sobikk/mouse/Mouse_design/Mouse_HW/vyroba/verze_1/BOM.ods

Označení | Velikost, typ | Pouzdro | Kód TME | Cena | Odkaz | Poznámky
C1 | 220k | 0402_1005 | 0402X224K100CT | 0,29776 | https://www.tme.eu/cz/details/0402x224k6r3ct/kondenzatory-mlcc-smd-0402/walsin/ | tolerance 10% | Min 250 | 0402X224K100CT | 5
C2 | 10m | 0603_1608 | CL10A106KQ8NNNC | 2,104 | https://www.tme.eu/cz/details/cl10a106kq8nnnc/kondenzatory-mlcc-smd-0603/samsung/ | tolerance 10% |  | CL10A106KQ8NNNC | 8
C3 | 100k | 0402_1005 | 0402X104K100CT | 0,1171 | https://www.tme.eu/cz/katalog/kondenzatory-mlcc-smd-0402_100568/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 | tolerance 10% | Min. 1000 | SMD0402-20K-1% | 16
C4 | 100k | 0402_1005 | 0402X104K100CT | 0,1171 | https://www.tme.eu/cz/katalog/kondenzatory-mlcc-smd-0402_100568/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 | tolerance 10% |  | SMD0603-130R-1% | 5
C5 | 100k | 0402_1005 | 0402X104K100CT | 0,1171 | https://www.tme.eu/cz/katalog/kondenzatory-mlcc-smd-0402_100568/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 | tolerance 10% |  | SMD0402-2K | 1
C6 | 10m | 0603_1608 | CL10A106KQ8NNNC | 2,104 | https://www.tme.eu/cz/details/cl10a106kq8nnnc/kondenzatory-mlcc-smd-0603/samsung/ | tolerance 10% |  | C0402C220J5GAC | 2
C7 | 220k | 0402_1005 | 0402X224K100CT | 0,29776 | https://www.tme.eu/cz/details/0402x224k6r3ct/kondenzatory-mlcc-smd-0402/walsin/ | tolerance 10% |  | ERJ3EKF2000V | 1
C8 | 10m | 0603_1608 | CL10A106KQ8NNNC | 2,104 | https://www.tme.eu/cz/details/cl10a106kq8nnnc/kondenzatory-mlcc-smd-0603/samsung/ | tolerance 10% |  | TS4148C-RZG | 5
C9 | 10m | 0603_1608 | CL10A106KQ8NNNC | 2,104 | https://www.tme.eu/cz/details/cl10a106kq8nnnc/kondenzatory-mlcc-smd-0603/samsung/ | tolerance 10% |  | D2F | 3
C10 | 100k | 0402_1005 | 0402X104K100CT | 0,1171 | https://www.tme.eu/cz/details/0402x104k100ct/kondenzatory-mlcc-smd-0402/walsin/ | tolerance 10% |  | 0402X104K100CT | 17
C11 | 220k | 0402_1005 | 0402X224K100CT | 0,29776 | https://www.tme.eu/cz/details/0402x224k6r3ct/kondenzatory-mlcc-smd-0402/walsin/ | tolerance 10% |  | CL10A105KO8NNNC | 1
C12 | 100k | 0402_1005 | 0402X104K100CT | 0,1171 | https://www.tme.eu/cz/details/0402x104k100ct/kondenzatory-mlcc-smd-0402/walsin/ | tolerance 10% |  | SMD0603-13R-1% | 1
C13 | 220k | 0402_1005 | 0402X224K100CT | 0,29776 | https://www.tme.eu/cz/details/0402x224k6r3ct/kondenzatory-mlcc-smd-0402/walsin/ | tolerance 10% |  | SMD0402-27.4K-1% | 1
C14 | 100k | 0402_1005 | 0402X104K100CT | 0,1171 | https://www.tme.eu/cz/details/0402x104k100ct/kondenzatory-mlcc-smd-0402/walsin/ | tolerance 10% |  | RF-AUB190TS-ED | 2
C15 | 100k | 0402_1005 | 0402X104K100CT | 0,1171 | https://www.tme.eu/cz/details/0402x104k100ct/kondenzatory-mlcc-smd-0402/walsin/ | tolerance 10% |  | B4B-PH-K-S | 2
C16 | 10m | 0603_1608 | CL10A106KQ8NNNC | 2,104 | https://www.tme.eu/cz/details/cl10a106kq8nnnc/kondenzatory-mlcc-smd-0603/samsung/ | tolerance 10% |  | 2PH1-40-UA | 3 | 10 pinů
C17 | 220k | 0402_1005 | 0402X224K100CT | 0,29776 | https://www.tme.eu/cz/details/0402x224k6r3ct/kondenzatory-mlcc-smd-0402/walsin/ | tolerance 10% |  | B3B-PH-K-S | 1
C18 | 10m | 0603_1608 | CL10A106KQ8NNNC | 2,104 | https://www.tme.eu/cz/details/cl10a106kq8nnnc/kondenzatory-mlcc-smd-0603/samsung/ | tolerance 10% |  | EC10E1220503 | 1
C19 | 100k | 0402_1005 | 0402X104K100CT | 0,1171 | https://www.tme.eu/cz/details/0402x104k100ct/kondenzatory-mlcc-smd-0402/walsin/ | tolerance 10% |  | 3314J-1-504E | 1
C20 | 20c | 0402_1005 | C0402C220J5GAC | 0,2448 | https://www.tme.eu/cz/details/c0402c220j5gac/kondenzatory-mlcc-smd-0402/kemet/c0402c220j5gactu/ | Tolerance 5% |  | BLM18TG102TN1D | 1
C21 | 20c | 0402_1005 | C0402C220J5GAC | 0,2448 | https://www.tme.eu/cz/details/c0402c220j5gac/kondenzatory-mlcc-smd-0402/kemet/c0402c220j5gactu/ | Tolerance 5% |  | MMBTA42LT1G | 1
C22 | 100k | 0402_1005 | 0402X104K100CT | 0,1171 | https://www.tme.eu/cz/details/0402x104k100ct/kondenzatory-mlcc-smd-0402/walsin/ | tolerance 10% |  | LD1117S33CTR | 1
C23 | 100k | 0402_1005 | 0402X104K100CT | 0,1171 | https://www.tme.eu/cz/details/0402x104k100ct/kondenzatory-mlcc-smd-0402/walsin/ | tolerance 10% |  | PMW3389DM-T3QU | 1
C24 | 100k | 0402_1005 | 0402X104K100CT | 0,1171 | https://www.tme.eu/cz/details/0402x104k100ct/kondenzatory-mlcc-smd-0402/walsin/ | tolerance 10% |  | LDCL015MR | 1
C25 | 10m | 0603_1608 | CL10A106KQ8NNNC | 2,104 | https://www.tme.eu/cz/details/cl10a106kq8nnnc/kondenzatory-mlcc-smd-0603/samsung/ | tolerance 10% |  | AD8556ARZ | 1 | odpájet
C26 | 100k | 0402_1005 | 0402X104K100CT | 0,1171 | https://www.tme.eu/cz/details/0402x104k100ct/kondenzatory-mlcc-smd-0402/walsin/ | tolerance 10% |  | STM32F070C6T6 | 1
C27 | 100k | 0402_1005 | 0402X104K100CT | 0,1171 | https://www.tme.eu/cz/details/0402x104k100ct/kondenzatory-mlcc-smd-0402/walsin/ | tolerance 10% |  | HC49USM-FF3F16.00 | 1
C28 | 100k | 0402_1005 | 0402X104K100CT | 0,1171 | https://www.tme.eu/cz/details/0402x104k100ct/kondenzatory-mlcc-smd-0402/walsin/ | tolerance 10%
C29 | 100k | 0402_1005 | 0402X104K100CT | 0,1171 | https://www.tme.eu/cz/details/0402x104k100ct/kondenzatory-mlcc-smd-0402/walsin/ | tolerance 10%
C30 | 100k | 0402_1005 | 0402X104K100CT | 0,1171 | https://www.tme.eu/cz/details/0402x104k100ct/kondenzatory-mlcc-smd-0402/walsin/ | tolerance 10% |  | 3314J-1-105E | 1
C31 | 1m | 0603_1608 | CL10A105KO8NNNC | 0,4035 | https://www.tme.eu/cz/details/cl10a105ko8nnnc/kondenzatory-mlcc-smd-0603/samsung/ | tolerance 10% |  | CRCW04020000Z0TDBC | 10
C32 | 100k | 0402_1005 | 0402X104K100CT | 0,1171 | https://www.tme.eu/cz/details/0402x104k100ct/kondenzatory-mlcc-smd-0402/walsin/ | tolerance 10% |  | CRCW06030000Z0TABC | 10
C33 | 10m | 0603_1608 | CL10A106KQ8NNNC | 2,104 | https://www.tme.eu/cz/details/cl10a106kq8nnnc/kondenzatory-mlcc-smd-0603/samsung/ | tolerance 10% |  | JUMPER-2.0/BL | 10
R1 | 20k | 0402_1005 | SMD0402-20K-1% | 0,288 | https://www.tme.eu/cz/details/smd0402-20k-1%25/rezistory-smd-0402/royal-ohm/0402wgf2002tce/ | Tol. 1% |  | DS1057-06A282R | 2
R2 | 20k | 0402_1005 | SMD0402-20K-1% | 0,288 | https://www.tme.eu/cz/details/smd0402-20k-1%25/rezistory-smd-0402/royal-ohm/0402wgf2002tce/ | Tol. 1% |  | ESAC305/8 | 2
R3 | 20k | 0402_1005 | SMD0402-20K-1% | 0,288 | https://www.tme.eu/cz/details/smd0402-20k-1%25/rezistory-smd-0402/royal-ohm/0402wgf2002tce/ | Tol. 1%
R4 | 20k | 0402_1005 | SMD0402-20K-1% | 0,288 | https://www.tme.eu/cz/details/smd0402-20k-1%25/rezistory-smd-0402/royal-ohm/0402wgf2002tce/ | Tol. 1%
R5 | 130R | 0603_1608 | SMD0603-130R-1% | 0,3468 | https://www.tme.eu/cz/details/smd0603-130r-1%25/rezistory-smd-0603/royal-ohm/0603saf1300t5e/ | Tol. 1% |  | PHR-4 | 6
R6 | 20k | 0402_1005 | SMD0402-20K-1% | 0,288 | https://www.tme.eu/cz/details/smd0402-20k-1%25/rezistory-smd-0402/royal-ohm/0402wgf2002tce/ | Tol. 1% |  | PHR-3 | 3
R7 | 20k | 0402_1005 | SMD0402-20K-1% | 0,288 | https://www.tme.eu/cz/details/smd0402-20k-1%25/rezistory-smd-0402/royal-ohm/0402wgf2002tce/ | Tol. 1% |  | SPH-002T-P0.5L/C | 50
R8 | 20k | 0402_1005 | SMD0402-20K-1% | 0,288 | https://www.tme.eu/cz/details/smd0402-20k-1%25/rezistory-smd-0402/royal-ohm/0402wgf2002tce/ | Tol. 1% |  | NB-JCRIMP09 | 1
R9 | 20k | 0402_1005 | SMD0402-20K-1% | 0,288 | https://www.tme.eu/cz/details/smd0402-20k-1%25/rezistory-smd-0402/royal-ohm/0402wgf2002tce/ | Tol. 1% |  | NB-CRIMP01H | 1
R10 | 130R | 0603_1608 | SMD0603-130R-1% | 0,3468 | https://www.tme.eu/cz/details/smd0603-130r-1%25/rezistory-smd-0603/royal-ohm/0603saf1300t5e/ | Tol. 1% |  | CBR04C150F5GAC | 2
R11 | 13R | 0603_1608 | SMD0603-13R-1% | 0,3468 | https://www.tme.eu/cz/details/smd0603-13r-1%25/rezistory-smd-0603/royal-ohm/0603saf130jt5e/ | Tol. 1%
R12 | 130R | 0603_1608 | SMD0603-130R-1% | 0,3468 | https://www.tme.eu/cz/details/smd0603-130r-1%25/rezistory-smd-0603/royal-ohm/0603saf1300t5e/ | Tol. 1% |  | D2FS-F-N | 3
R13 | 27k4 | 0402_1005 | SMD0402-27.4K-1% | 0,3942 | https://www.tme.eu/cz/details/smd0402-27.4k-1%25/rezistory-smd-0402/royal-ohm/0402wgf2742tce/ | Tol. 1%
R14 | 20k | 0402_1005 | SMD0402-20K-1% | 0,288 | https://www.tme.eu/cz/details/smd0402-20k-1%25/rezistory-smd-0402/royal-ohm/0402wgf2002tce/ | Tol. 1%
R15 | 20k | 0402_1005 | SMD0402-20K-1% | 0,288 | https://www.tme.eu/cz/details/smd0402-20k-1%25/rezistory-smd-0402/royal-ohm/0402wgf2002tce/ | Tol. 1%
R16 | 20k | 0402_1005 | SMD0402-20K-1% | 0,288 | https://www.tme.eu/cz/details/smd0402-20k-1%25/rezistory-smd-0402/royal-ohm/0402wgf2002tce/ | Tol. 1%
R17 | 130R | 0603_1608 | SMD0603-130R-1% | 0,3468 | https://www.tme.eu/cz/details/smd0603-130r-1%25/rezistory-smd-0603/royal-ohm/0603saf1300t5e/ | Tol. 1%
R18 | 130R | 0603_1608 | SMD0603-130R-1% | 0,3468 | https://www.tme.eu/cz/details/smd0603-130r-1%25/rezistory-smd-0603/royal-ohm/0603saf1300t5e/ | Tol. 1%
R19 | 20k | 0402_1005 | SMD0402-20K-1% | 0,288 | https://www.tme.eu/cz/details/smd0402-20k-1%25/rezistory-smd-0402/royal-ohm/0402wgf2002tce/ | Tol. 1%
R20 | 2k | 0402_1005 | SMD0402-2K | 0,26 | https://www.tme.eu/cz/details/smd0402-2k/rezistory-smd-0402/royal-ohm/0402wgj0202tce/ | Tol. 5%
R21 | 20k | 0402_1005 | SMD0402-20K-1% | 0,288 | https://www.tme.eu/cz/details/smd0402-20k-1%25/rezistory-smd-0402/royal-ohm/0402wgf2002tce/ | Tol. 1%
R22 | 200R | 0603_1608 | ERJ3EKF2000V | 0,5061 | https://www.tme.eu/cz/details/erj3ekf2000v/rezistory-smd-0603/panasonic/ | Tol. 1%
R23 | 20k | 0402_1005 | SMD0402-20K-1% | 0,288 | https://www.tme.eu/cz/details/smd0402-20k-1%25/rezistory-smd-0402/royal-ohm/0402wgf2002tce/ | Tol. 1%
R24 | 20k | 0402_1005 | SMD0402-20K-1% | 0,288 | https://www.tme.eu/cz/details/smd0402-20k-1%25/rezistory-smd-0402/royal-ohm/0402wgf2002tce/ | Tol. 1%
R25 | 20k | 0402_1005 | SMD0402-20K-1% | 0,288 | https://www.tme.eu/cz/details/smd0402-20k-1%25/rezistory-smd-0402/royal-ohm/0402wgf2002tce/ | Tol. 1%
D1 | 0,1A, 75V | 0603_1608 | TS4148C-RZG | 0,7913
D2 | 0,1A, 75V | 0603_1608 | TS4148C-RZG | 0,7913
D3 | 0,1A, 75V | 0603_1608 | TS4148C-RZG | 0,7913
D4 | 0,1A, 75V | 0603_1608 | TS4148C-RZG | 0,7913
D5 | 0,1A, 75V | 0603_1608 | TS4148C-RZG | 0,7913
D6 | LED 1,8-2,4V | 0603_1608 | RF-AUB190TS-ED | 1,832
D7 | LED 1,8-2,4V | 0603_1608 | RF-AUB190TS-ED | 1,832
J1 |  | PH-4 | B4B-PH-K-S | 4,99192
J2 | hřeben 1x4 | 2mm rastr | 2PH1-40-UA | 2,182 | https://www.tme.eu/cz/details/2ph1-40-ua/konektory-hrebinky/adam-tech/
J3 |  | PH-4 | B4B-PH-K-S | 4,99192
J4 | hřeben 1x3 | 2mm rastr | 2PH1-40-UA | 1,6365 | https://www.tme.eu/cz/details/2ph1-40-ua/konektory-hrebinky/adam-tech/
J5 | hřeben 1x3 | 2mm rastr | 2PH1-40-UA | 1,6365 | https://www.tme.eu/cz/details/2ph1-40-ua/konektory-hrebinky/adam-tech/
J6 |  | PH-3 | B3B-PH-K-S | 3,81828
SW1 |  | SNAP ACTION | D2F | 16,35
SW2 |  | SNAP ACTION | D2F | 16,35
SW3 |  | 11mm height | EC10E1220503 | 22,36
SW4 |  | SNAP ACTION | D2F | 16,35
RV1 | 500k | 3314J | 3314J-1-504E | 42,22 | https://www.tme.eu/cz/details/3314j-1-504e/potenciometry-jednootackove-smd/bourns/
FB1 | 0,35Ohm | 0603_1608 | BLM18TG102TN1D | 0,2736
Q1 | NPN | SOT-23 | MMBTA42LT1G | 0,6728
U1 | 3,3V reg. | SOT-223 | LD1117S33CTR | 7,9133
U2 | opt. Sensor | special | PMW3389DM-T3QU
U3 | 1,9V reg. | SOT-23-5 | LDCL015MR | 25,72
U4 | InAmp | SO8 | AD8556ARZ | 217,62
U5 | STM32F070C6 | LQFP48 | STM32F070C6T6 | 54,26 | https://www.tme.eu/cz/details/stm32f070c6t6/mikroprocesory-st/stmicroelectronicshttps://www.tme.eu/cz/detailhttps://www.tme.eu/cz/details
Y1 | 16MHz osc. | SMD | HC49USM-FF3F16.00 | 12,12
RV1 (2) | 1m | 3314J | 3314J-1-105E | 42,22 | https://www.tme.eu/cz/details/3314j-1-504e/potenciometry-jednootackove-smd/bourns/
propojky SMD | 0Ohm | 0402_1005 | CRCW04020000Z0TDBC | 0,27141
propojky SMD | 0Ohm | 0603_1608 | CRCW06030000Z0TABC | 0,28068
jumpery |  |  | JUMPER-2.0/BL
kabely |  | 6xAWG28 | DS1057-06A282R | 141,33
pajka |  |  | ESAC305/8
Switch 1 | D2FS-F-N
Switch 2 | D2F
Konektor |  | PH-4 | PHR-4 | 1,88852
Konektor |  | PH-4 | PHR-4 | 1,88852
Konektor |  | PH-3 | PHR-3 | 1,88852
Koncovka |  | SPH-002T-P0.5L | SPH-002T-P0.5L/C | 0,0545 | Kabel 0,08÷0,22mm2
Kleště |  |  | NB-JCRIMP09 | 242,15
 |  |  | NB-CRIMP01H | 370,22
C20* | 15c | 0402_1005 | CBR04C150F5GAC | 5,08959
