sobikk/mouse/Mouse_design/Mouse_HW/vyroba/verze_2/Mys-Edge_Cuts.dxf

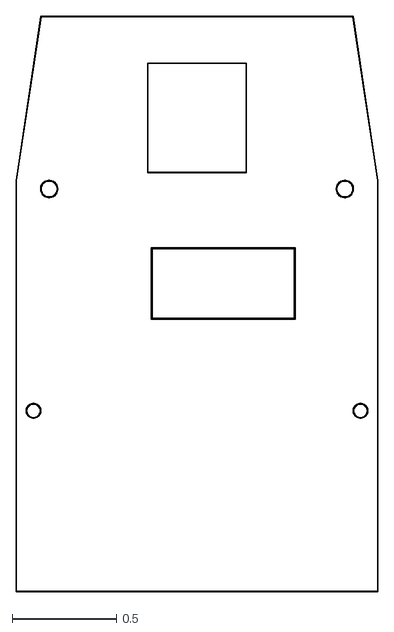
[picture p1: CAD file, 2021-01-28]
Mouse_design/Mouse_HW/vyroba/verze_2/Mys-Edge_Cuts.dxf
1.73 x 2.76
