sobikk/mouse/Mouse_design/Mouse_HW/kicad_project/Mys.kicad_pcb

## KiCad design Mouse_design/Mouse_HW/kicad_project/Mys.kicad_pcb (2021-01-28)

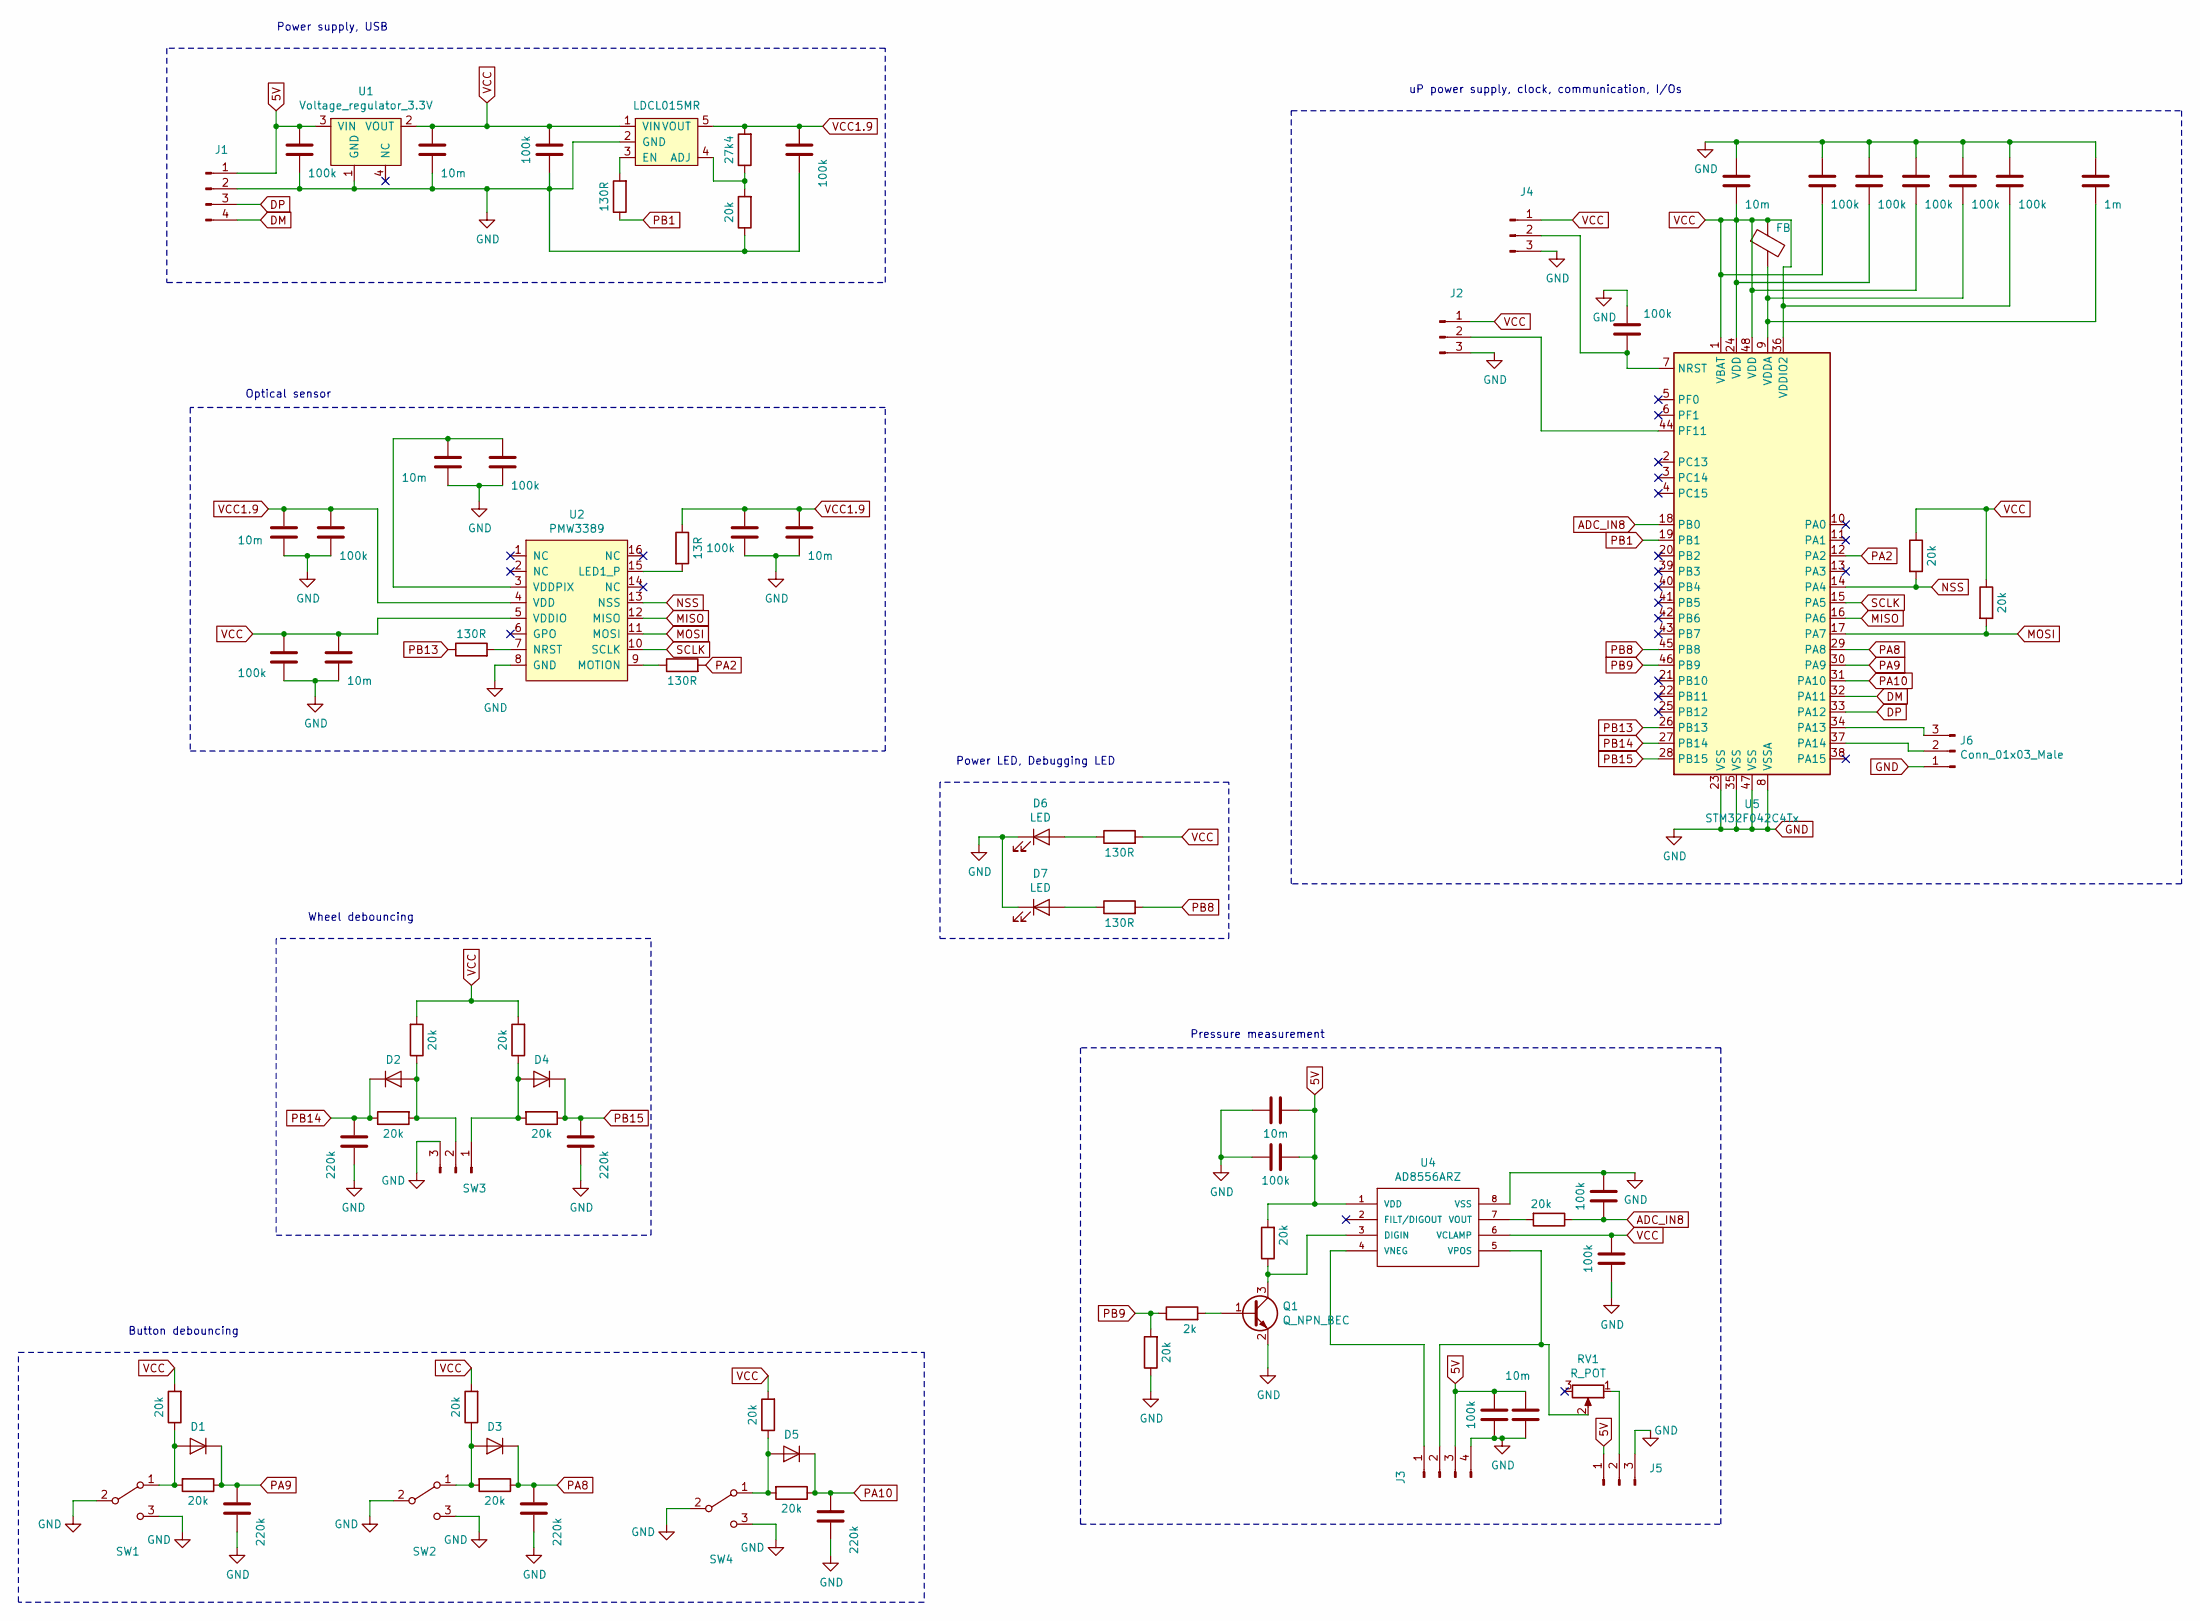
[picture p2: schematic Mys.sch]

Parts:
C1, C7, C11, C13, C17: 220k; C_0402_1005Metric
C2, C6, C8, C9, C16, C18, C25, C33: 10m; C_0603_1608Metric_Pad1.05x0.95mm_HandSolder
C3, C4, C5, C10, C12, C14, C15, C19, C22, C23, C24, C26, C27, C28, C29, C30, C32: 100k; C_0402_1005Metric
C31: 1m; C_0603_1608Metric_Pad1.05x0.95mm_HandSolder
D1, D2, D3, D4, D5: D; D_0603_1608Metric_Pad1.05x0.95mm_HandSolder
D6, D7: LED; LED_0603_1608Metric_Pad1.05x0.95mm_HandSolder
FB1: FB; L_0603_1608Metric_Pad1.05x0.95mm_HandSolder
J1: Conn_01x04_Male; NXW-04
J2, J4, J5, J6: Conn_01x03_Male; PinHeader_1x03_P2.00mm_Vertical
J3: Conn_01x04_Male; PinHeader_1x04_P2.00mm_Vertical
Q1: Q_NPN_BEC; SOT-23
R1, R2, R3, R4, R6, R7, R8, R9, R14, R15, R16, R19, R21, R23, R24, R25: 20k; R_0402_1005Metric
R5, R10, R12, R17, R18: 130R; R_0603_1608Metric_Pad1.05x0.95mm_HandSolder
R11: 13R; R_0603_1608Metric_Pad1.05x0.95mm_HandSolder
R13: 27k4; R_0402_1005Metric
R20: 2k; R_0402_1005Metric
RV1: R_POT; Potentiometer_Bourns_3214J_Horizontal
SW1, SW2, SW4: SW_SPDT; Button_mouse
SW3: Conn_01x03_Male; Encoder
U1: Voltage_regulator_3.3V; SOT-223
U2: PMW3389; PMW3389DM-T3QU
U3: LDCL015MR; SOT-23-5_HandSoldering
U4: AD8556ARZ; SOIC-8_3.9x4.9mm_P1.27mm
U5: STM32F042C4Tx; LQFP-48_7x7mm_P0.5mm

Connections:
5V: C4.2, C18.2, C19.2, C32.2, C33.2, J1.1, J3.3, J5.1, R21.2, U1.3 (VIN), U4.1 (VDD)
ADC_IN8: C22.2, R23.1, U5.18 (PB0)
DM: J1.4, U5.32 (PA11)
DP: J1.3, U5.33 (PA12)
GND: C1.1, C2.1, C3.1, C4.1, C5.1, C6.1, C7.1, C8.1, C9.1, C10.1, C11.1, C12.1, C13.1, C14.1, C15.1, C16.1, C17.1, C18.1, C19.1, C22.1, C23.2, C24.2, C25.2, C26.2, C27.2, C28.2, C29.2, C30.2, C31.2, C32.1, C33.1, D6.1 (K), D7.1 (K), J1.2, J2.3, J3.4, J4.3, J5.3, J6.1, Q1.2 (E), R14.1, R19.1, SW1.2 (B), SW1.3 (C), SW2.2 (B), SW2.3 (C), SW3.3, SW4.2 (B), SW4.3 (C), U1.1 (GND), U2.8 (GND), U3.2 (GND), U4.8 (VSS), U5.8 (VSSA), U5.23 (VSS), U5.35 (VSS), U5.47 (VSS)
MISO: U2.12 (MISO), U5.16 (PA6)
MOSI: R25.2, U2.11 (MOSI), U5.17 (PA7)
NSS: R24.2, U2.13 (NSS), U5.14 (PA4)
unnamed: C9.2, C10.2, U2.3 (VDDPIX)
unnamed: C24.1, J4.2, U5.7 (NRST)
unnamed: C29.1, C31.1, FB1.2, U5.9 (VDDA)
unnamed: D1.2 (A), R1.1, R2.2, SW1.1 (A)
unnamed: D2.2 (A), R3.2, R4.1, SW3.2
unnamed: D3.2 (A), R6.1, R7.2, SW2.1 (A)
unnamed: D4.2 (A), R8.1, R9.2, SW3.1
unnamed: D5.2 (A), R15.1, R16.2, SW4.1 (A)
unnamed: D6.2 (A), R17.1
unnamed: D7.2 (A), R18.1
unnamed: J2.2, U5.44 (PF11)
unnamed: J3.1, U4.4 (VNEG)
unnamed: J3.2, RV1.2, U4.5 (VPOS)
unnamed: J5.2, RV1.1
unnamed: J6.2, U5.37 (PA14)
unnamed: J6.3, U5.34 (PA13)
unnamed: Q1.1 (B), R20.2
unnamed: Q1.3 (C), R21.1, U4.3 (DIGIN)
unnamed: R5.2, U2.7 (NRST)
unnamed: R10.2, U3.3 (EN)
unnamed: R11.2, U2.15 (LED1_P)
unnamed: R12.1, U2.9 (MOTION)
unnamed: R13.1, R14.2, U3.4 (ADJ)
unnamed: R23.2, U4.7 (VOUT)
PA2: R12.2, U5.12 (PA2)
PA8: C11.2, D3.1 (K), R7.1, U5.29 (PA8)
PA9: C1.2, D1.1 (K), R2.1, U5.30 (PA9)
PA10: C17.2, D5.1 (K), R16.1, U5.31 (PA10)
PB1: R10.1, U5.19 (PB1)
PB8: R18.2, U5.45 (PB8)
PB9: R19.2, R20.1, U5.46 (PB9)
PB13: R5.1, U5.26 (PB13)
PB14: C7.2, D2.1 (K), R3.1, U5.27 (PB14)
PB15: C13.2, D4.1 (K), R9.1, U5.28 (PB15)
SCLK: U2.10 (SCLK), U5.15 (PA5)
VCC: C3.2, C6.2, C8.2, C12.2, C23.1, C25.1, C26.1, C27.1, C28.1, C30.1, FB1.1, J2.1, J4.1, R1.2, R4.2, R6.2, R8.2, R15.2, R17.2, R24.1, R25.1, U1.2 (VOUT), U2.5 (VDDIO), U3.1 (VIN), U4.6 (VCLAMP), U5.1 (VBAT), U5.24 (VDD), U5.36 (VDDIO2), U5.48 (VDD)
VCC1.9: C2.2, C5.2, C14.2, C15.2, C16.2, R11.1, R13.2, U2.4 (VDD), U3.5 (VOUT)

Notes on the sheet:
Button debouncing
Wheel debouncing
Power LED, Debugging LED
Optical sensor
Pressure measurement
Power supply, USB
uP power supply, clock, communication, I/Os

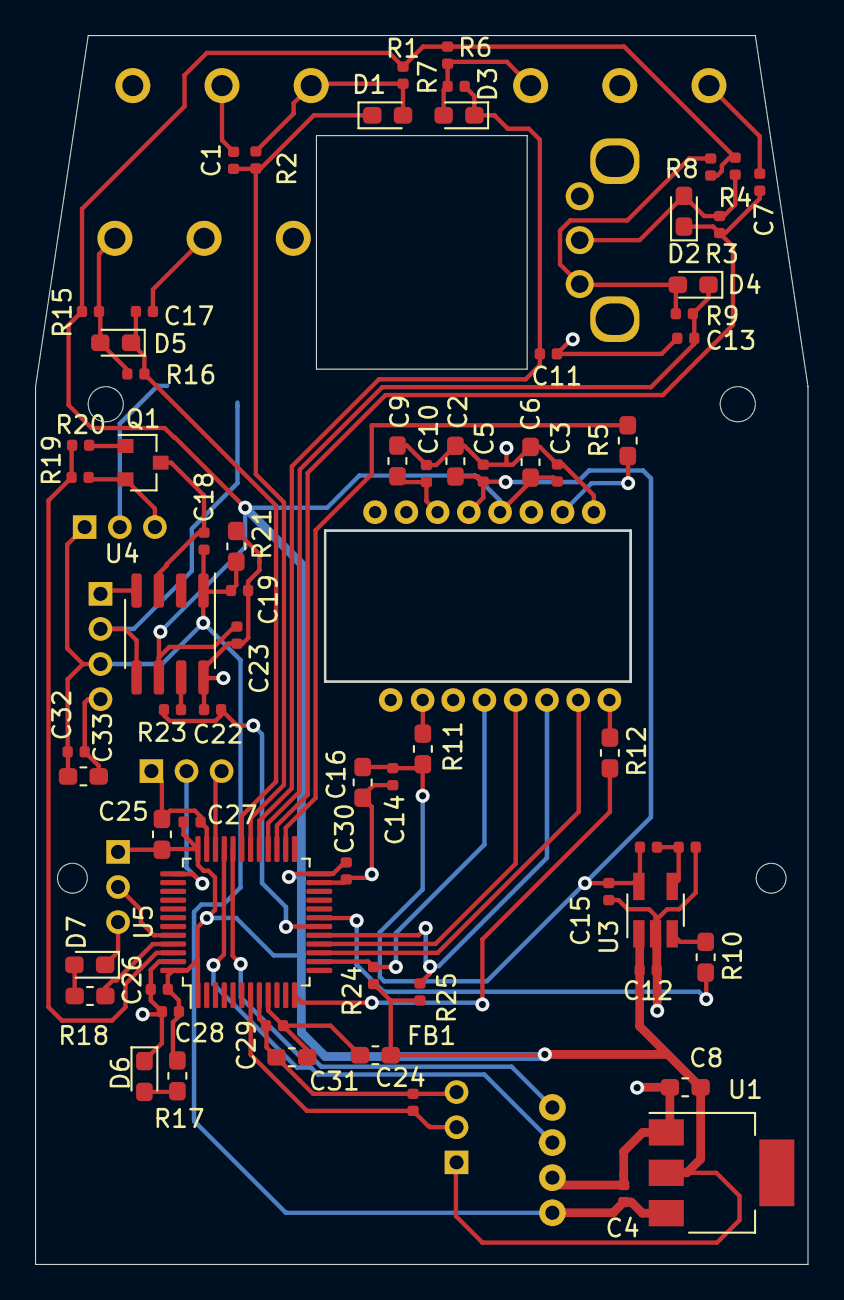
[picture p3: board Mys.kicad_pcb from above]

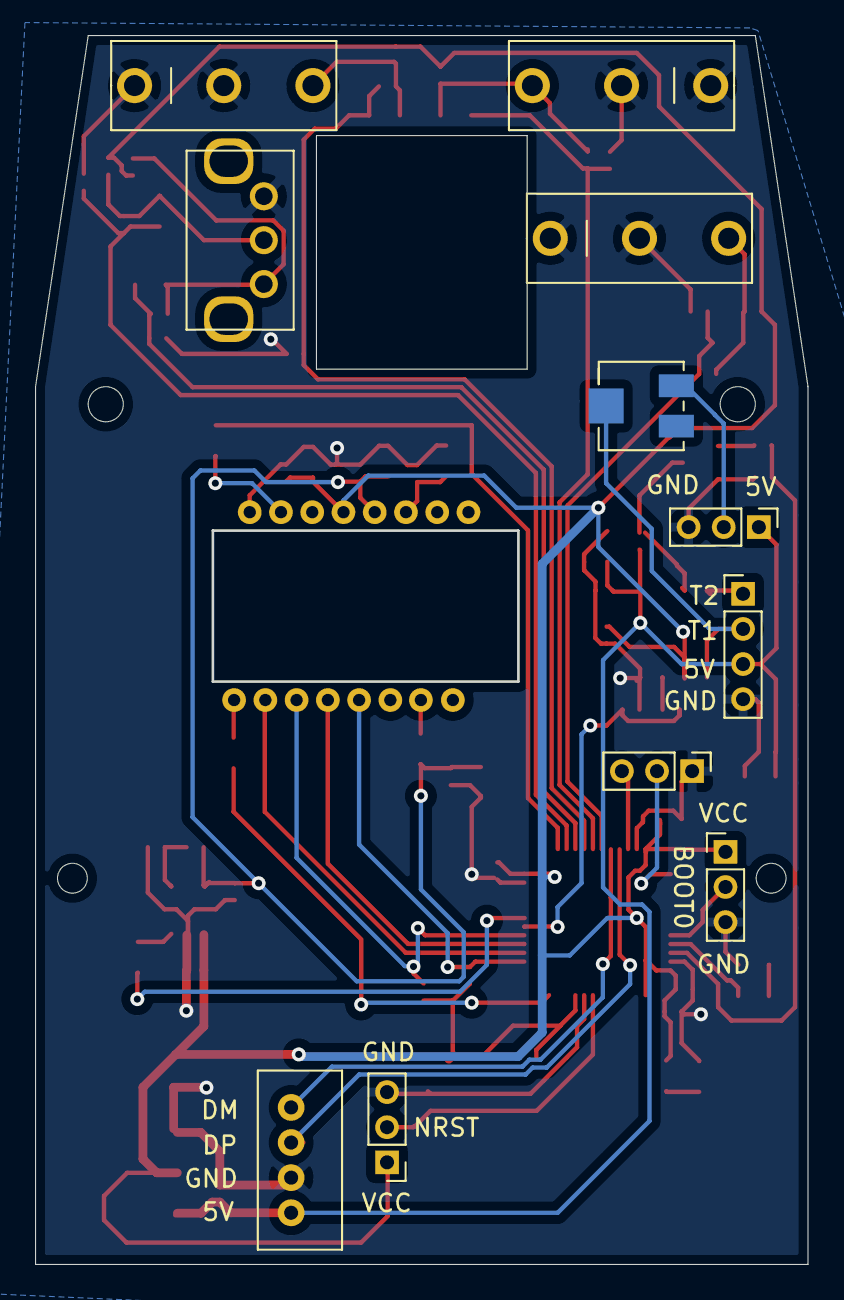
[picture p4: board Mys.kicad_pcb from below]

Board: 2 copper layers, 44.0 x 70.0 mm, 80 parts (11 on the bottom side), 45 nets.
