sobikk/mouse/Mouse_design/Mouse_FW/Drivers/Modul drivers/inc/OMS_SROMdata.h

/*
 * OMS_SROMdata.h
 *
 *  Created on: Jan 26, 2021
 *      Author: sobik
 */

#ifndef MODUL_DRIVERS_OMS_SROMDATA_H_
#define MODUL_DRIVERS_OMS_SROMDATA_H_

#include "stdint.h"

const uint8_t OMS_firmware[] =
{
0x01,
0x06,
0x88,
0x9e,
0x7e,
0x4c,
0x7e,
0x7e,
0x7e,
0x5f,
0x1d,
0xb8,
0xf2,
0x66,
0x2f,
0xdc,
0x3a,
0xd7,
0x2c,
0xba,
0xf4,
0x4b,
0x16,
0x8b,
0x75,
0x68,
0x33,
0xe4,
0x2b,
0xd4,
0x2a,
0xb7,
0xec,
0x5a,
0x36,
0xcf,
0xfd,
0x59,
0x11,
0xa0,
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
};

#endif /* MODUL_DRIVERS_OMS_SROMDATA_H_ */
